Risto97/primenjena_projekat2/kicad/primenjena_projekat2/car_pcb/car_pcb.kicad_pcb

## KiCad design kicad/primenjena_projekat2/car_pcb/car_pcb.kicad_pcb (2019-02-22)

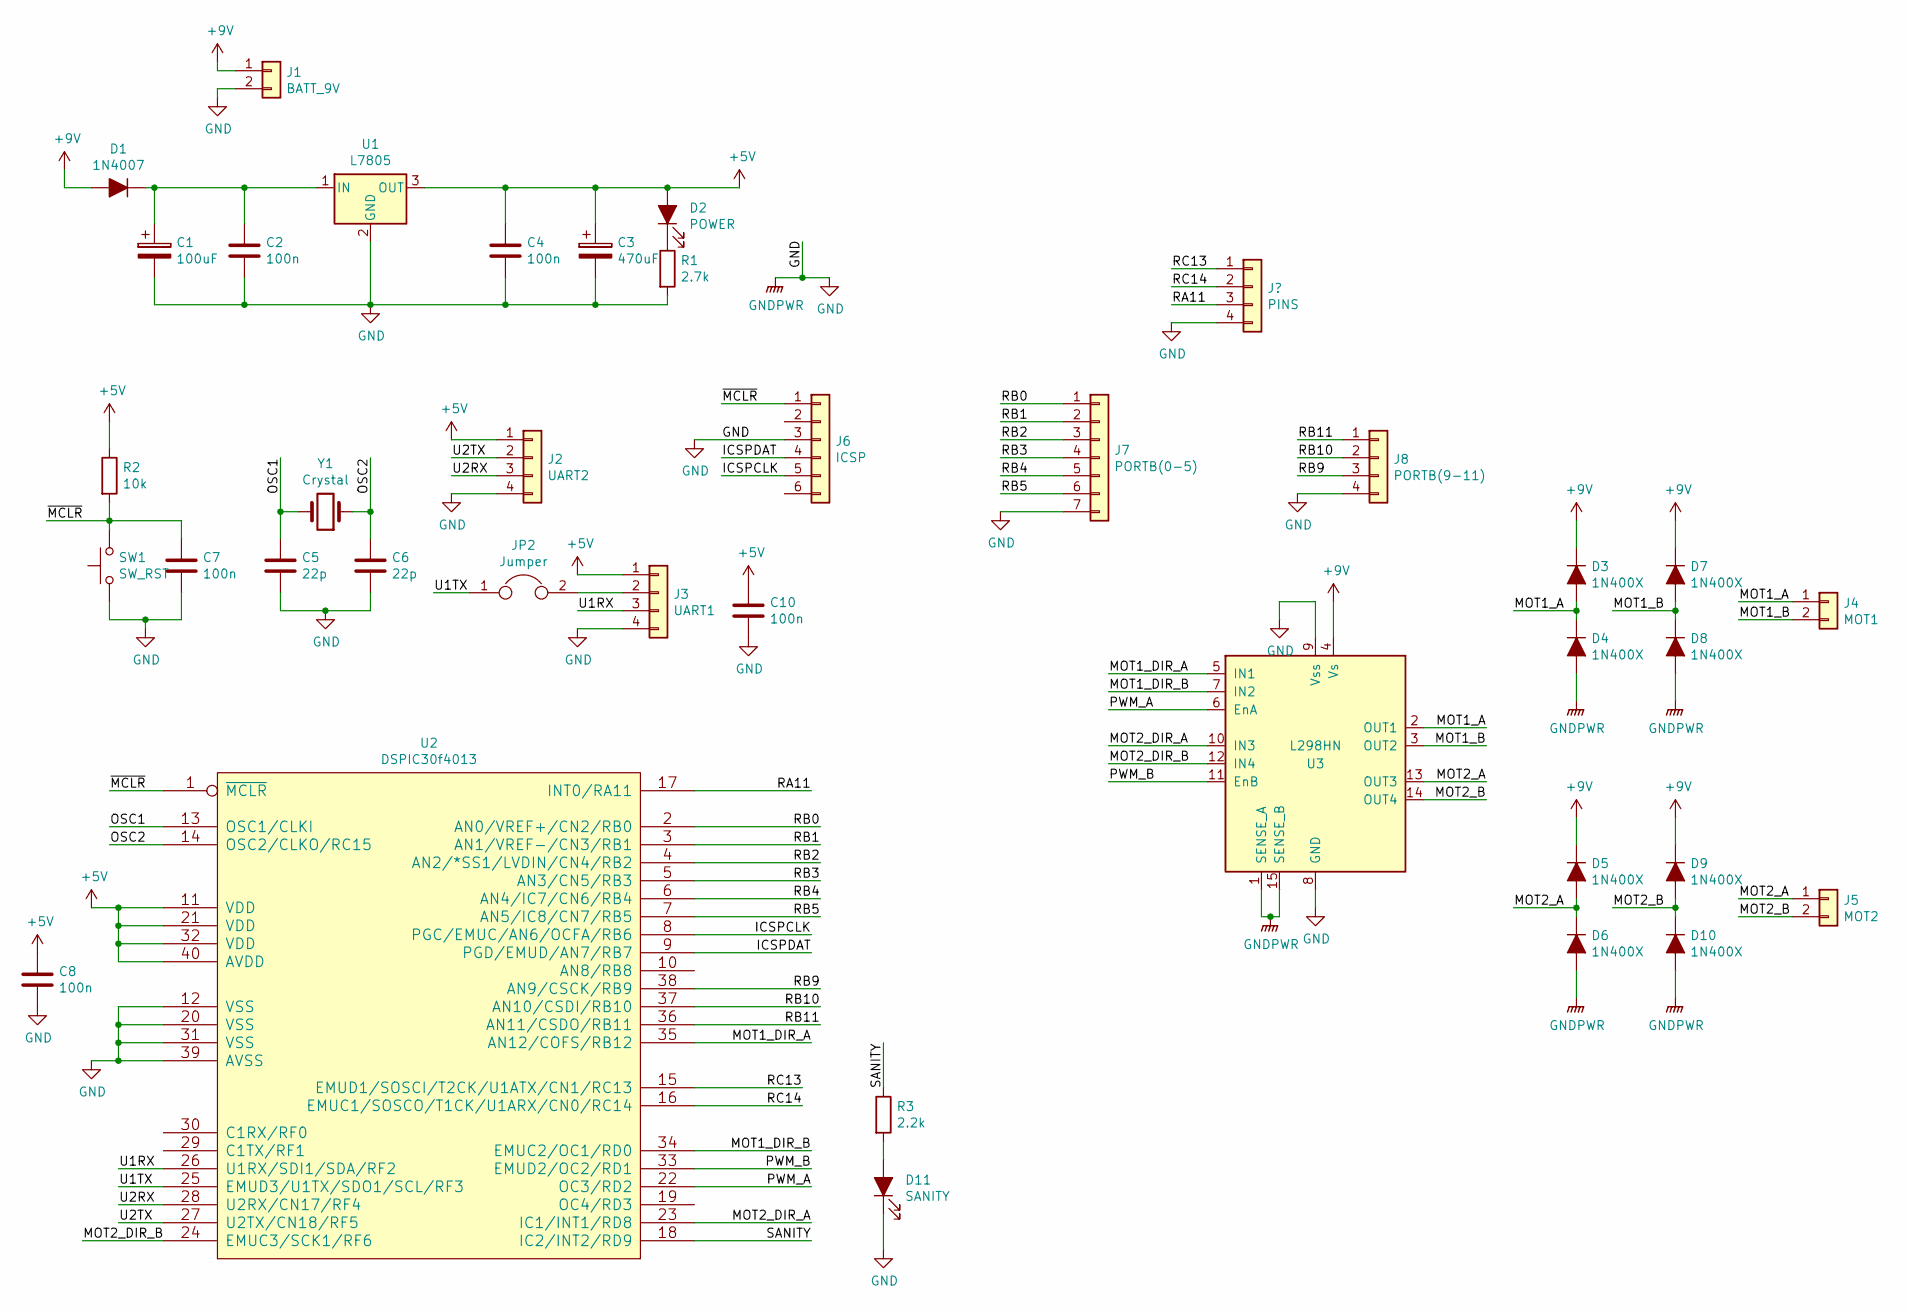
[picture p1: schematic car_pcb.sch]

Parts:
C1: 100uF; CP_Radial_D7.5mm_P2.50mm
C2, C4, C7, C8, C10: 100n; C_Disc_D5.0mm_W2.5mm_P5.00mm
C3: 470uF; CP_Radial_D7.5mm_P2.50mm
C5, C6: 22p; C_Disc_D5.0mm_W2.5mm_P2.50mm
D1: 1N4007; D_DO-34_SOD68_P7.62mm_Horizontal
D2: POWER; LED_D5.0mm
D3, D4, D5, D6, D7, D8, D9, D10: 1N400X; D_DO-34_SOD68_P10.16mm_Horizontal
D11: SANITY; LED_D5.0mm
J1: BATT_9V; TerminalBlock_Altech_AK300-2_P5.00mm
J2: UART2; PinHeader_1x04_P2.54mm_Vertical
J3: UART1; PinHeader_1x04_P2.54mm_Vertical
J4: MOT1; TerminalBlock_Altech_AK300-2_P5.00mm
J5: MOT2; TerminalBlock_Altech_AK300-2_P5.00mm
J6: ICSP; PinHeader_1x06_P2.54mm_Vertical
J7: PORTB(0-5); PinHeader_1x07_P2.54mm_Vertical
J8: PORTB(9-11); PinHeader_1x04_P2.54mm_Vertical
JP2: Jumper; PinHeader_1x02_P2.54mm_Vertical
R1: 2.7k; R_Axial_DIN0207_L6.3mm_D2.5mm_P10.16mm_Horizontal
R2: 10k; R_Axial_DIN0207_L6.3mm_D2.5mm_P10.16mm_Horizontal
R3: 2.2k; R_Axial_DIN0207_L6.3mm_D2.5mm_P10.16mm_Horizontal
SW1: SW_RST; SW_PUSH_6mm
U1: L7805; TO-220-3_Vertical
U2: DSPIC30f4013; DIP-40_W15.24mm_LongPads
U3: L298HN; TO-220-15_P2.54x2.54mm_StaggerOdd_Lead4.58mm_Vertical
Y1: Crystal; Crystal_HC50_Vertical

Connections:
+5V: C3.1, C4.1, C8.1, C10.1, D2.2 (A), J2.1, J3.1, R2.1, U1.3 (OUT), U2.11 (VDD), U2.21 (VDD), U2.32 (VDD), U2.40 (AVDD)
+9V: D1.2 (A), D3.1 (K), D5.1 (K), D7.1 (K), D9.1 (K), J1.1, U3.4 (Vs)
/ICSPCLK: J6.5, U2.8 (PGC/EMUC/AN6/OCFA/RB6)
/ICSPDAT: J6.4, U2.9 (PGD/EMUD/AN7/RB7)
/MOT1_A: D3.2 (A), D4.1 (K), J4.1, U3.2 (OUT1)
/MOT1_B: D7.2 (A), D8.1 (K), J4.2, U3.3 (OUT2)
/MOT1_DIR_A: U2.35 (AN12/COFS/RB12), U3.5 (IN1)
/MOT1_DIR_B: U2.34 (EMUC2/OC1/RD0), U3.7 (IN2)
/MOT2_A: D5.2 (A), D6.1 (K), J5.1, U3.13 (OUT3)
/MOT2_B: D9.2 (A), D10.1 (K), J5.2, U3.14 (OUT4)
/MOT2_DIR_A: U2.23 (IC1/INT1/RD8), U3.10 (IN3)
/MOT2_DIR_B: U2.24 (EMUC3/SCK1/RF6), U3.12 (IN4)
/OSC1: C5.1, U2.13 (OSC1/CLKI), Y1.2
/OSC2: C6.1, U2.14 (OSC2/CLKO/RC15), Y1.1
/PWM_A: U2.22 (OC3/RD2), U3.6 (EnA)
/PWM_B: U2.33 (EMUD2/OC2/RD1), U3.11 (EnB)
/RA11: U2.17 (INT0/RA11); also elsewhere on the board
/RB0: J7.1, U2.2 (AN0/VREF+/CN2/RB0)
/RB1: J7.2, U2.3 (AN1/VREF-/CN3/RB1)
/RB2: J7.3, U2.4 (AN2/*SS1/LVDIN/CN4/RB2)
/RB3: J7.4, U2.5 (AN3/CN5/RB3)
/RB4: J7.5, U2.6 (AN4/IC7/CN6/RB4)
/RB5: J7.6, U2.7 (AN5/IC8/CN7/RB5)
/RB9: J8.3, U2.38 (AN9/CSCK/RB9)
/RB10: J8.2, U2.37 (AN10/CSDI/RB10)
/RB11: J8.1, U2.36 (AN11/CSDO/RB11)
/RC13: U2.15 (EMUD1/SOSCI/T2CK/U1ATX/CN1/RC13); also elsewhere on the board
/RC14: U2.16 (EMUC1/SOSCO/T1CK/U1ARX/CN0/RC14); also elsewhere on the board
/SANITY: R3.1, U2.18 (IC2/INT2/RD9)
/U1RX: J3.3, U2.26 (U1RX/SDI1/SDA/RF2)
/U1TX: JP2.1, U2.25 (EMUD3/U1TX/SDO1/SCL/RF3)
/U2RX: J2.3, U2.28 (U2RX/CN17/RF4)
/U2TX: J2.2, U2.27 (U2TX/CN18/RF5)
/~MCLR: C7.1, J6.1, R2.2, SW1.2, U2.1 (~MCLR)
GND: C1.2, C2.2, C3.2, C4.2, C5.2, C6.2, C7.2, C8.2, C10.2, D4.2 (A), D6.2 (A), D8.2 (A), D10.2 (A), D11.1 (K), J1.2, J2.4, J3.4, J6.3, J7.7, J8.4, R1.2, SW1.1, U1.2 (GND), U2.12 (VSS), U2.20 (VSS), U2.31 (VSS), U2.39 (AVSS), U3.1 (SENSE_A), U3.8 (GND), U3.9 (Vss), U3.15 (SENSE_B); also elsewhere on the board
unnamed: C1.1, C2.1, D1.1 (K), U1.1 (IN)
unnamed: D2.1 (K), R1.1
unnamed: D11.2 (A), R3.2
unnamed: J3.2, JP2.2

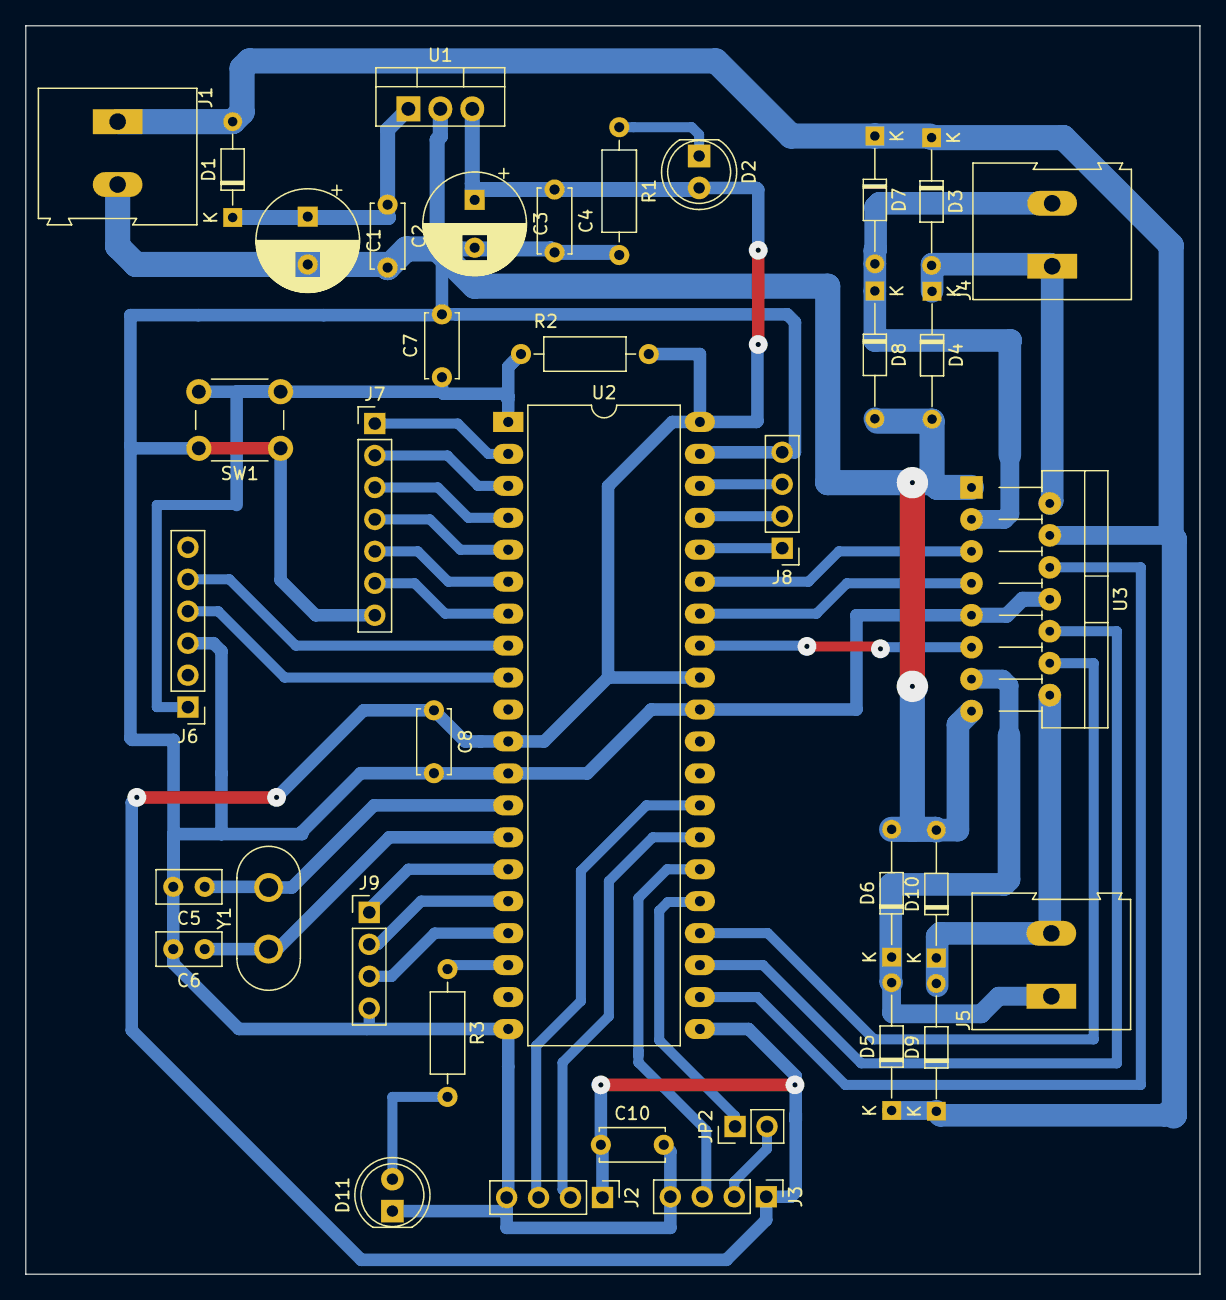
[picture p2: board car_pcb.kicad_pcb from above]

Board: 2 copper layers, 93.3 x 99.3 mm, 38 parts (0 on the bottom side), 39 nets.

Other parts of the board:
J9: PINS; PinHeader_1x04_P2.54mm_Vertical

Their connections:
/RA11: J9.3; also elsewhere on the board
/RC13: J9.1; also elsewhere on the board
/RC14: J9.2; also elsewhere on the board
GND: J9.4; also elsewhere on the board
