Risto97/primenjena_projekat2/kicad/primenjena_projekat2/remote_pcb/remote_pcb.kicad_pcb

## KiCad design kicad/primenjena_projekat2/remote_pcb/remote_pcb.kicad_pcb (2019-02-19)

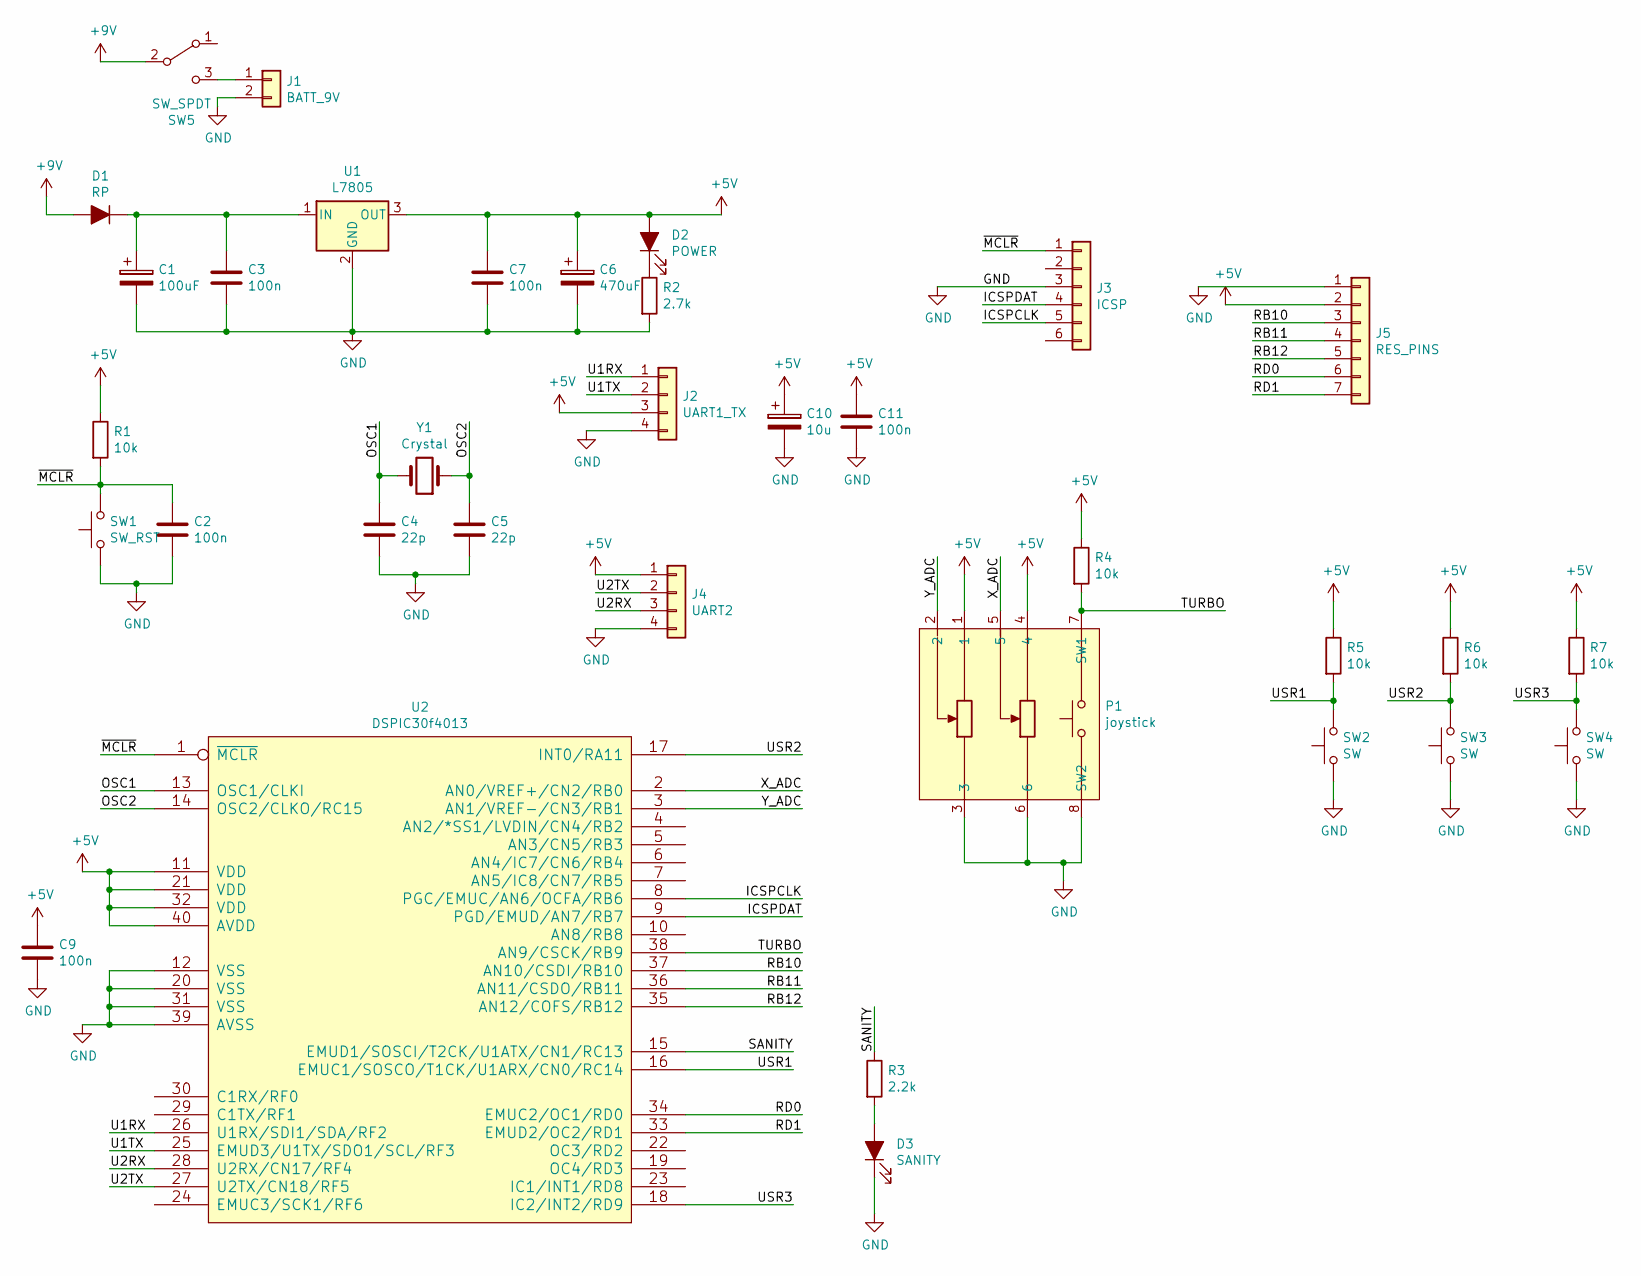
[picture p3: schematic remote_pcb.sch]

Parts:
C1: 100uF; CP_Radial_D7.5mm_P2.50mm
C2, C3, C7, C9, C11: 100n; C_Disc_D5.0mm_W2.5mm_P2.50mm
C4, C5: 22p; C_Disc_D5.0mm_W2.5mm_P2.50mm
C6: 470uF; CP_Radial_D7.5mm_P2.50mm
C10: 10u; CP_Radial_D5.0mm_P2.50mm
D1: RP; D_DO-34_SOD68_P7.62mm_Horizontal
D2: POWER; LED_D5.0mm
D3: SANITY; LED_D5.0mm
J1: BATT_9V; TerminalBlock_Altech_AK300-2_P5.00mm
J2: UART1_TX; PinHeader_1x04_P2.54mm_Vertical
J3: ICSP; PinHeader_1x06_P2.54mm_Vertical
J4: UART2; PinHeader_1x04_P2.54mm_Vertical
J5: RES_PINS; PinHeader_1x07_P2.54mm_Vertical
P1: joystick
R1, R4, R5, R6, R7: 10k; R_Axial_DIN0207_L6.3mm_D2.5mm_P10.16mm_Horizontal
R2: 2.7k; R_Axial_DIN0207_L6.3mm_D2.5mm_P10.16mm_Horizontal
R3: 2.2k; R_Axial_DIN0207_L6.3mm_D2.5mm_P10.16mm_Horizontal
SW1: SW_RST; SW_PUSH_6mm
SW2, SW3, SW4: SW; SW_PUSH_6mm
SW5: SW_SPDT; TerminalBlock_RND_205-00068_1x03_P7.50mm_Horizontal
U1: L7805; TO-220-3_Vertical
U2: DSPIC30f4013; DIP-40_W15.24mm_LongPads
Y1: Crystal; Crystal_HC50_Vertical

Connections:
+5V: C6.1, C7.1, C9.1, C10.1, C11.1, D2.2 (A), J2.3, J4.1, J5.2, P1.1, P1.4, R1.1, R4.1, R5.1, R6.1, R7.1, U1.3 (OUT), U2.11 (VDD), U2.21 (VDD), U2.32 (VDD), U2.40 (AVDD)
+9V: D1.2 (A), SW5.2 (B)
/ICSPCLK: J3.5, U2.8 (PGC/EMUC/AN6/OCFA/RB6)
/ICSPDAT: J3.4, U2.9 (PGD/EMUD/AN7/RB7)
/OSC1: C4.1, U2.13 (OSC1/CLKI), Y1.2
/OSC2: C5.1, U2.14 (OSC2/CLKO/RC15), Y1.1
/RB10: J5.3, U2.37 (AN10/CSDI/RB10)
/RB11: J5.4, U2.36 (AN11/CSDO/RB11)
/RB12: J5.5, U2.35 (AN12/COFS/RB12)
/RD0: J5.6, U2.34 (EMUC2/OC1/RD0)
/RD1: J5.7, U2.33 (EMUD2/OC2/RD1)
/SANITY: R3.1, U2.15 (EMUD1/SOSCI/T2CK/U1ATX/CN1/RC13)
/TURBO: P1.7 (SW1), R4.2, U2.38 (AN9/CSCK/RB9)
/U1RX: J2.1, U2.26 (U1RX/SDI1/SDA/RF2)
/U1TX: J2.2, U2.25 (EMUD3/U1TX/SDO1/SCL/RF3)
/U2RX: J4.3, U2.28 (U2RX/CN17/RF4)
/U2TX: J4.2, U2.27 (U2TX/CN18/RF5)
/USR1: R5.2, SW2.2, U2.16 (EMUC1/SOSCO/T1CK/U1ARX/CN0/RC14)
/USR2: R6.2, SW3.2, U2.17 (INT0/RA11)
/USR3: R7.2, SW4.2, U2.18 (IC2/INT2/RD9)
/X_ADC: P1.5, U2.2 (AN0/VREF+/CN2/RB0)
/Y_ADC: P1.2, U2.3 (AN1/VREF-/CN3/RB1)
/~MCLR: C2.1, J3.1, R1.2, SW1.2, U2.1 (~MCLR)
GND: C1.2, C2.2, C3.2, C4.2, C5.2, C6.2, C7.2, C9.2, C10.2, C11.2, D3.1 (K), J1.2, J2.4, J3.3, J4.4, J5.1, P1.3, P1.6, P1.8 (SW2), R2.2, SW1.1, SW2.1, SW3.1, SW4.1, U1.2 (GND), U2.12 (VSS), U2.20 (VSS), U2.31 (VSS), U2.39 (AVSS)
unnamed: C1.1, C3.1, D1.1 (K), U1.1 (IN)
unnamed: D2.1 (K), R2.1
unnamed: D3.2 (A), R3.2
unnamed: J1.1, SW5.3 (C)

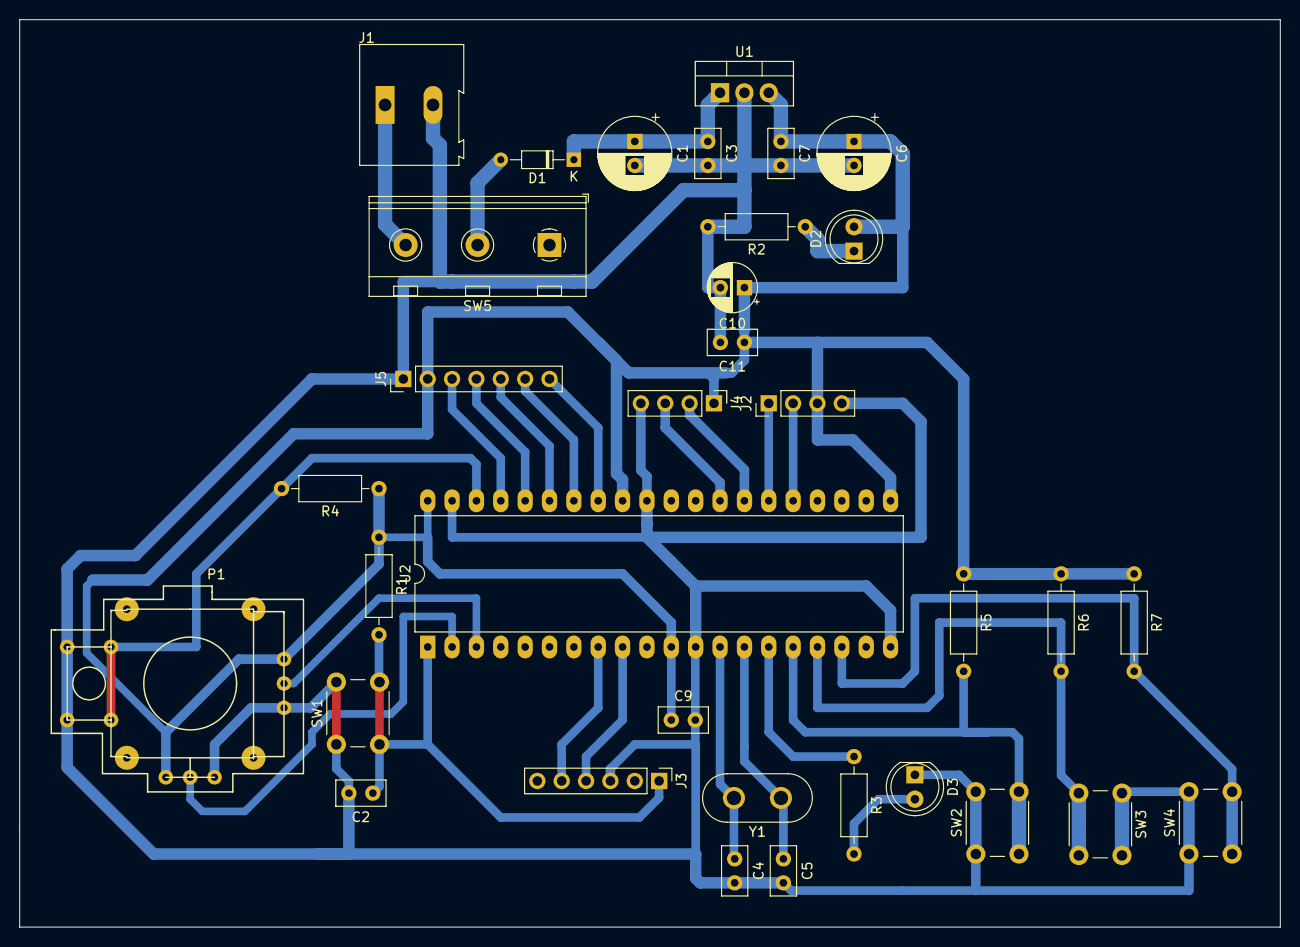
[picture p4: board remote_pcb.kicad_pcb from above]

Board: 2 copper layers, 131.4 x 94.6 mm, 34 parts (0 on the bottom side), 28 nets.
