Risto97/primenjena_projekat2/sw/car.X/configuration_bits.c

/******************************************************************************/
/* Files to Include                                                           */
/******************************************************************************/

/* Device header file */
#if defined(__XC16__)
    #include <xc.h>
#elif defined(__C30__)
    #if defined(__dsPIC30F__)
        #include <p30Fxxxx.h>
    #endif
#endif

/******************************************************************************/
/* Configuration Bits                                                         */
/*                                                                            */
/* This is not all available configuration bits for all dsPIC devices.        */
/* Refer to the dsPIC device specific .h file in the compiler installation    */
/* support\dsPIC30F\h directory for complete options specific to the device   */
/* selected.  For additional information about what the hardware              */
/* configurations mean in terms of device operation, refer to the device      */
/* datasheet 'Special Features' chapter.                                      */
/*                                                                            */
/* A feature of MPLAB X is the 'Generate Source Code to Output' utility in    */
/* the Configuration Bits window.  Under Window > PIC Memory Views >          */
/* Configuration Bits, a user controllable configuration bits window is       */
/* available to generate configuration bits source code which the user can    */
/* then paste into this project.                                              */
/******************************************************************************/

/* TODO Fill in your configuration bits from the config bits generator here.  */

// DSPIC30F4013 Configuration Bit Settings

// 'C' source line config statements

// FOSC
#pragma config FOSFPR = HS3_PLL4              // Oscillator (HS)
#pragma config FCKSMEN = CSW_FSCM_OFF   // Clock Switching and Monitor (Sw Disabled, Mon Disabled)

// FWDT
#pragma config FWPSB = WDTPSB_16        // WDT Prescaler B (1:16)
#pragma config FWPSA = WDTPSA_512       // WDT Prescaler A (1:512)
#pragma config WDT = WDT_OFF            // Watchdog Timer (Disabled)

// FBORPOR
#pragma config FPWRT = PWRT_64          // POR Timer Value (64ms)
#pragma config BODENV = BORV20          // Brown Out Voltage (Reserved)
#pragma config BOREN = PBOR_ON          // PBOR Enable (Enabled)
#pragma config MCLRE = MCLR_EN          // Master Clear Enable (Enabled)

// FGS
#pragma config GWRP = GWRP_OFF          // General Code Segment Write Protect (Disabled)
#pragma config GCP = CODE_PROT_OFF      // General Segment Code Protection (Disabled)

// FICD
#pragma config ICS = ICS_PGD            // Comm Channel Select (Use PGC/EMUC and PGD/EMUD)

// #pragma config statements should precede project file includes.
// Use project enums instead of #define for ON and OFF.

#include <xc.h>
