Risto97/primenjena_projekat2/(commit log)

2019-02-14 change schematic name
    [car_pcb.sch, primenjena_projekat2.kicad_pcb, primenjena_projekat2.sch]
2019-02-15 add remote control schematic
    [remote_pcb.kicad_pcb, remote_pcb.sch]
2019-02-15 split PCBs
    [car_pcb.sch, remote_pcb.kicad_pcb]
2019-02-19 Remote control PCB
    [car_pcb.sch, remote_pcb.kicad_pcb, remote_pcb.sch]
2019-02-22 Add car PCB
    [_saved_car_pcb.sch, car_pcb.kicad_pcb, car_pcb.sch]
2019-03-03 Fix steering motor jamming
    [motor_con.c]
2019-03-05 Fix stability with RF modules
    [main.c, message.c, message.h, motor_con.c, uart_rf.c, uart_rf.h]
2019-03-05 Update uart_rf.c
    fix
